M-guillaume/BabyCare/Anechoic_Chamber_Measurements/screen/screen Patch 915 MHz.jpg

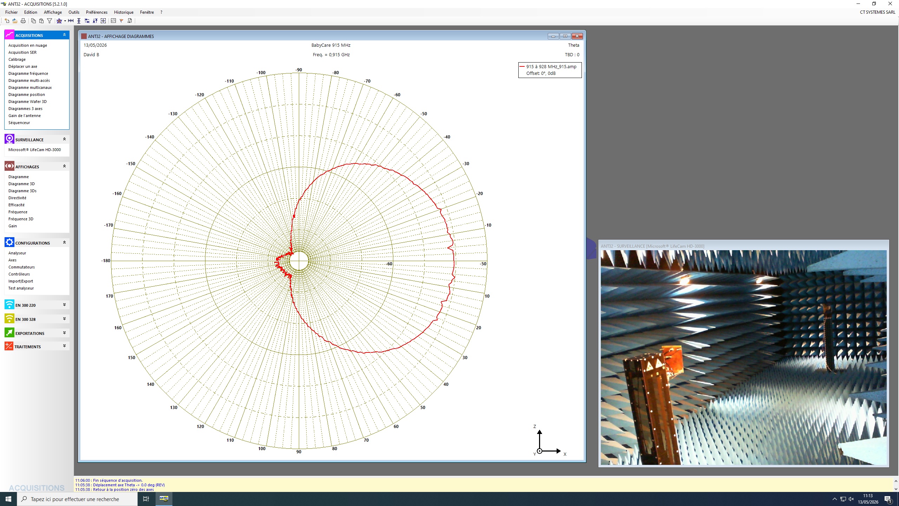
Anechoic_Chamber_Measurements/screen/screen Patch 915 MHz.jpg
