M-guillaume/BabyCare/Mobile_App/README.md

# BabyCare Mobile Application 📱

Mobile application developed for the **BabyCare** project.  
The application provides a user interface to monitor the child detection system embedded in a vehicle and alerts the user in case of a dangerous situation.

The application communicates with the BabyCare embedded system through **Bluetooth Low Energy (BLE)** to receive real-time information and notifications.

---

## 🚀 Features

### 🔵 Bluetooth Low Energy Communication
- Automatic scanning of nearby BabyCare devices
- Connection with the embedded system using BLE
- Real-time reception of alerts and status updates

### 👶 Child Safety Monitoring
- Monitoring of the child detection system
- Notification when a potential danger is detected
- Real-time system status display

### 📱 User Interface
- Simple and intuitive interface
- Connection status visualization
- Alert display for the user

---

## 🛠️ Technologies

### Mobile Application

| Technology | Description |
|---|---|
| Flutter | Cross-platform mobile framework |
| Dart | Programming language |
| FlutterBluePlus | BLE communication library |

### Supported Platforms

- Android ✅
- IOS ✅

## ⚙️ Installation

### Requirements

- Flutter SDK installed
- Android Studio or VS Code
- Android device with Bluetooth Low Energy support
