M-guillaume/BabyCare/BabyCare_Box/BabyCare_box.png

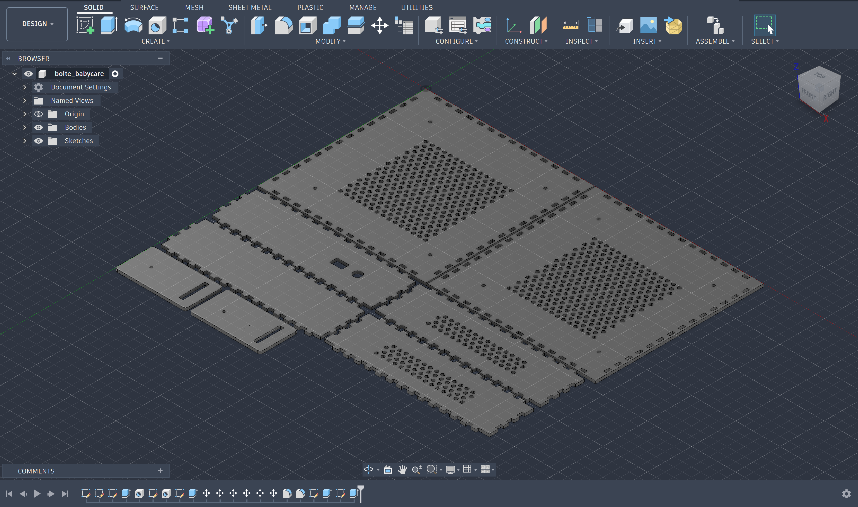
BabyCare_Box/BabyCare_box.png
