M-guillaume/BabyCare/Mobile_App/android/play_store/ic_launcher_playstore.png

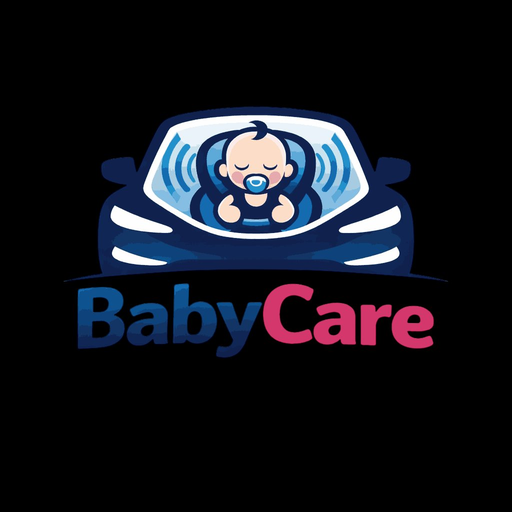
Mobile_App/android/play_store/ic_launcher_playstore.png
