M-guillaume/BabyCare/Radar_Conditioning_Board/Electronic circuit.PNG

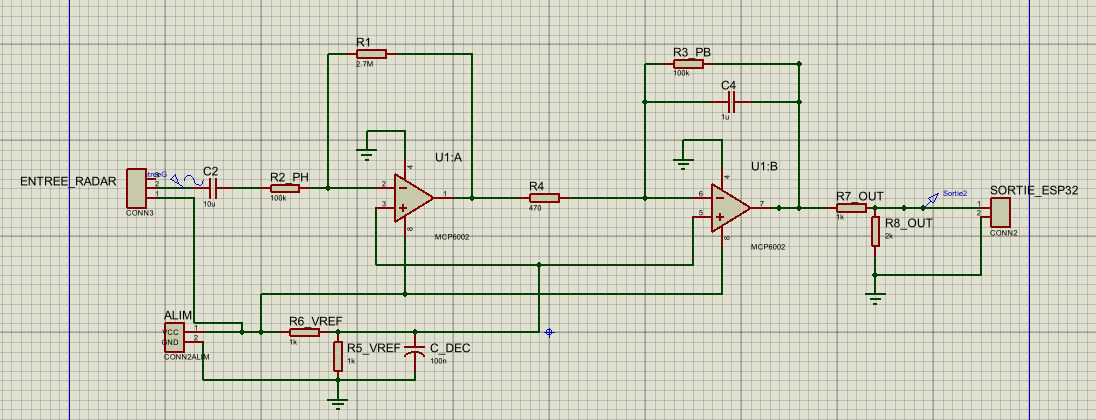
Radar_Conditioning_Board/Electronic circuit.PNG
