M-guillaume/BabyCare/Radar_Conditioning_Board/layout.PNG

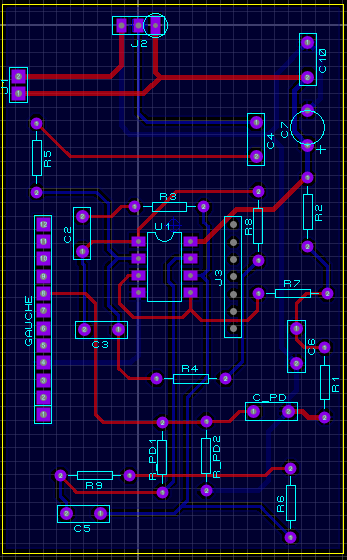
Radar_Conditioning_Board/layout.PNG
