M-guillaume/BabyCare/(list of files, cad)

Other CAD files:
BabyCare_Box/BabyCare_box.dwg
