M-guillaume/BabyCare/Anechoic_Chamber_Measurements/screen/Patch 3D +90 915 Mhz 3of3.PNG

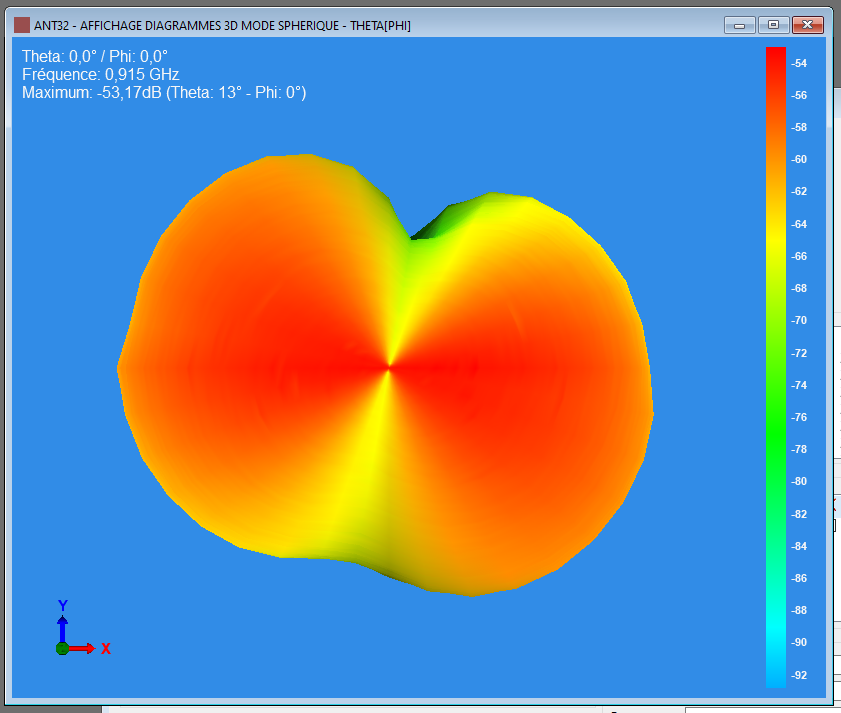
Anechoic_Chamber_Measurements/screen/Patch 3D +90 915 Mhz 3of3.PNG
