M-guillaume/BabyCare/Anechoic_Chamber_Measurements/screen/Patch 3D cut +00 915Mhz 1of2.PNG

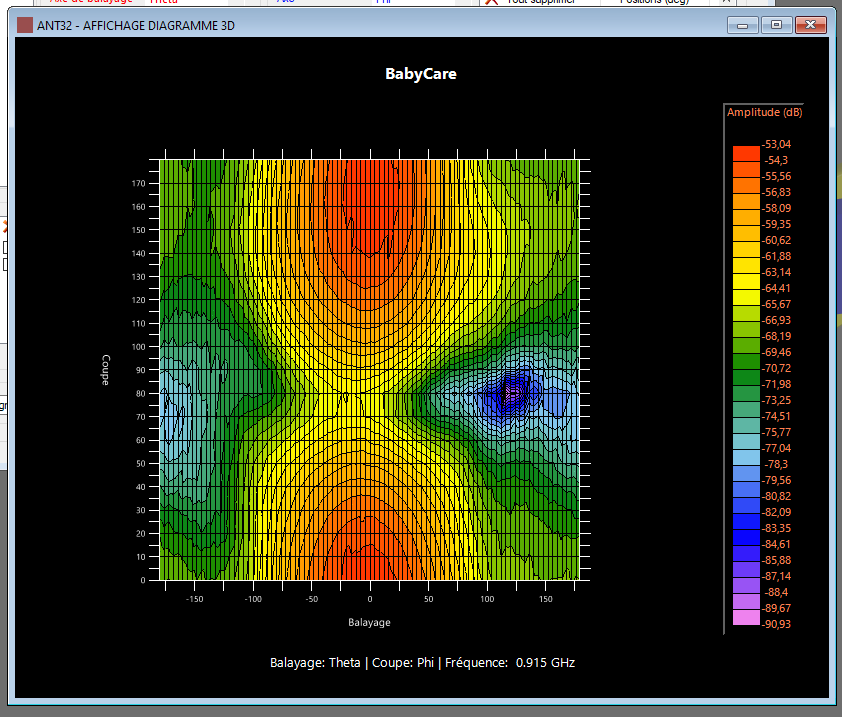
Anechoic_Chamber_Measurements/screen/Patch 3D cut +00 915Mhz 1of2.PNG
