M-guillaume/BabyCare/Anechoic_Chamber_Measurements/screen/Patch 3D cut +60 915Mhz 2of2.PNG

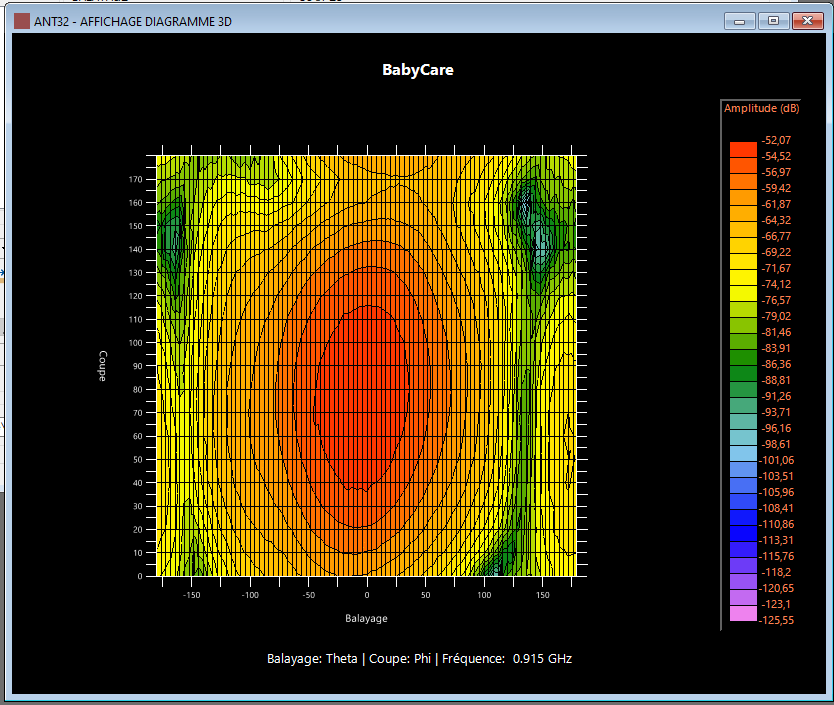
Anechoic_Chamber_Measurements/screen/Patch 3D cut +60 915Mhz 2of2.PNG
