M-guillaume/BabyCare/Anechoic_Chamber_Measurements/screen/PIFA 3D 2.45Ghz +00 pola 0 deg 2of2.PNG

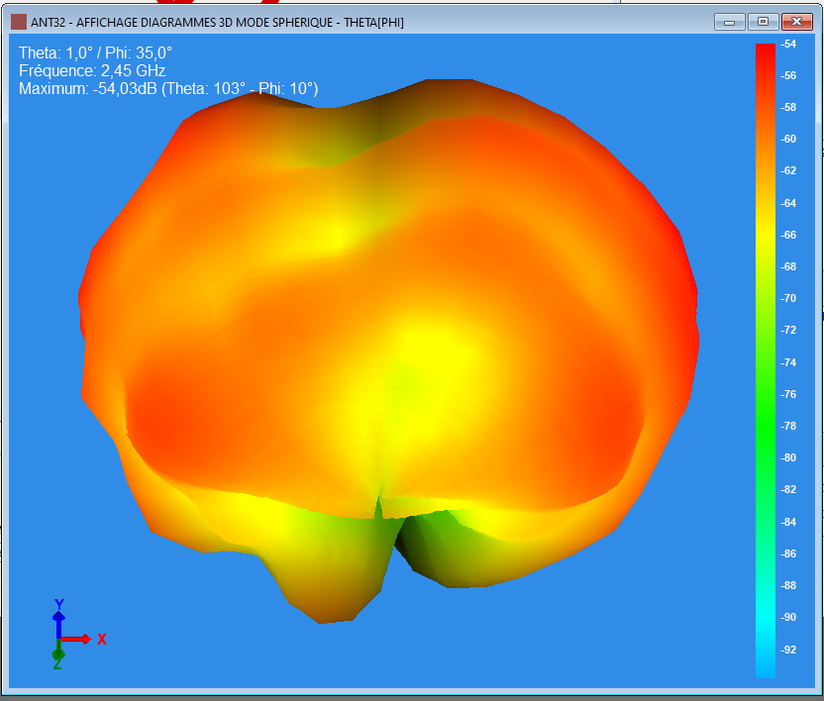
Anechoic_Chamber_Measurements/screen/PIFA 3D 2.45Ghz +00 pola 0 deg 2of2.PNG
