M-guillaume/BabyCare/Anechoic_Chamber_Measurements/screen/PIFA 3D cut 2.45Ghz +90 pola 0 deg.PNG

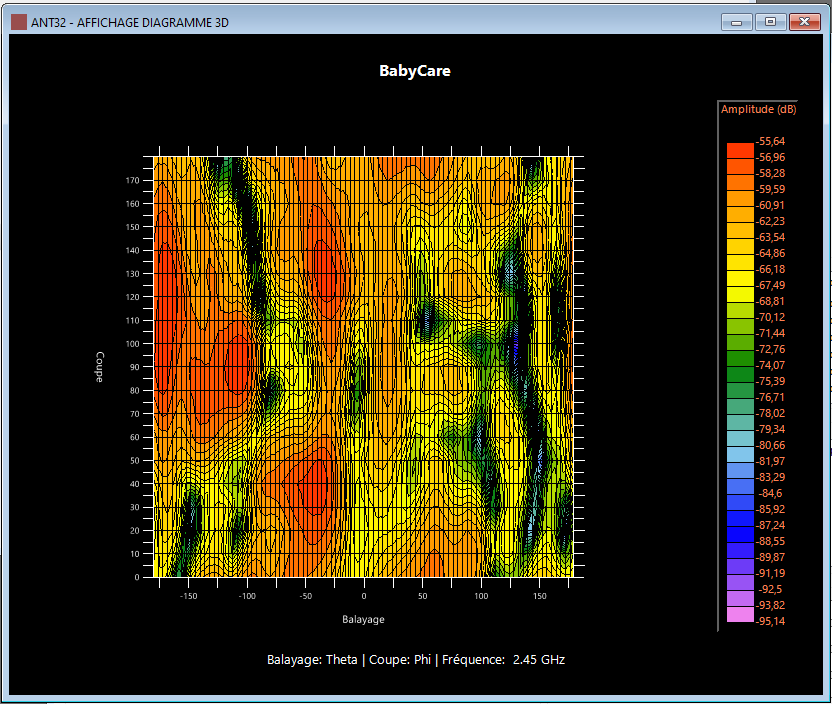
Anechoic_Chamber_Measurements/screen/PIFA 3D cut 2.45Ghz +90 pola 0 deg.PNG
