M-guillaume/BabyCare/(list of files, drawings)

Other design files:
Custom_Motherboard_PCB/Custom_Motherboard_PCB.pdsprj
Radar_Conditioning_Board/Radar Conditioning Board.pdsprj
